HasnainNisar/sky130-5t-ota/(commit log)

2026-11-10 Add schematic for OTA circuit
    [ota_5t.sch]
2026-11-10 Add device definitions to devs.txt
2026-11-10 Update README with 5T OTA design details
    Added detailed information about the 5T OTA design, including specifications, sizing, schematic, simulation results, limitations, tools used, and instructions on how to run the simulation.
